Aeghur/2026_10_6/dpll_dds_fpga/mspm0/Keil_DPLL/README.md

# MSPM0G3519 DPLL控制工程

Keil入口：`Project/dpll_dds.uvprojx`。

已使用Keil µVision 5、ARM Compiler 6.24完成全量编译：0 error、0 warning。
本机生成的烧录文件位于`Output/dpll_dds_mspm0.hex`；`Output`属于构建产物，
不提交Git，可随时由工程重新生成。

功能：

- UART4以2 Mbaud连接DPLL FPGA；
- UART1以1 Mbaud连接PC；
- 将PC的0～359.99°目标相位转换为32 bit FPGA相位字；
- 查询FPGA频率、锁定、OTR和DAC削顶状态；
- 保持现有`scope.py`的设置相位、单次采集和结果帧兼容。
- 支持`dpll_control.py`实时读取频率、锁定、相位误差和DAC码。

PC UART1的时钟分频、中断方式和引脚配置与已上板验证可通信的旧工程保持一致；
FPGA UART4状态查询带有限超时，FPGA未连接时MSPM0仍会及时向PC返回错误帧。

新FPGA不再上传4096点ADC/FFT数据，因此兼容结果中仅返回一个中心采样点和
一个状态幅值点。PC界面仍可显示频率、CRC、OTR、DAC削顶和调相状态，时域及
频谱图不再代表实际采集波形。

工程复用仓库根目录`KeyBoardpro/Source`中的TI DriverLib，避免复制整套SDK。
因此不要单独移动本目录；应保持它位于当前仓库结构中。

接线：

| 方向 | MSPM0 | FPGA | 波特率 |
|---|---|---|---:|
| MSPM0→FPGA | PB10/UART4_TX | T13/uart_rx | 2 Mbaud |
| FPGA→MSPM0 | PB11/UART4_RX | R13/uart_tx | 2 Mbaud |
| PC→MSPM0 | PB5/UART1_RX | USB-TTL TX | 1 Mbaud |
| MSPM0→PC | PB4/UART1_TX | USB-TTL RX | 1 Mbaud |

所有数字设备使用3.3 V逻辑并共地。

烧录与启动：

1. 用Keil打开`Project/dpll_dds.uvprojx`，选择`DPLL_DDS_MSPM0G3519`。
2. 执行Build，确认生成`Output/dpll_dds_mspm0.hex`。
3. 用UniFlash烧录该HEX；如果已经在Keil目标选项中配置好板载调试器，也可直接Download。
4. FPGA先烧录`quartus/output_files/dpll_dds.sof`，再给MSPM0复位。
5. PC运行仓库原界面，选择MSPM0对应串口和1,000,000 baud。

推荐使用根目录的DPLL专用诊断脚本进行首次调试：

```powershell
cd E:\eishero2q\ad9226
python -m pip install -r requirements.txt
python dpll_control.py --port COM6 --phase 0
```

将`COM6`换成设备管理器中USB-TTL对应端口。按`Ctrl+C`停止；测试90°时重新运行
并改为`--phase 90`。脚本每250 ms显示频率、锁定、输入有效、环路相位误差、
当前DAC码、削顶和ADC OTR。

上电后MSPM0会自动向FPGA发送0°、幅度2143、相位校准180°、输出使能的默认配置。
180°固定校准来自40 kHz上板验证：未校准时物理输入/输出约反相，临时设置
180°命令后示波器读数变为约5.945°/354.0°。该固定项只修正板级极性，剩余
频率相关残差应通过后续扫频表补偿。
如果暂时不接MSPM0，FPGA的UART RX必须上拉到3.3 V；DPLL实时锁相本身仍在FPGA
中运行，但不能从PC设置相位或读取状态。
