Aeghur/2026_10_6/dpll_dds_fpga/mspm0/Keil_DPLL/User/ti_msp_dl_config.c

/*
 * Copyright (c) 2023, Texas Instruments Incorporated
 * All rights reserved.
 *
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
 * *  Redistributions of source code must retain the above copyright
 *    notice, this list of conditions and the following disclaimer.
 *
 * *  Redistributions in binary form must reproduce the above copyright
 *    notice, this list of conditions and the following disclaimer in the
 *    documentation and/or other materials provided with the distribution.
 *
 * *  Neither the name of Texas Instruments Incorporated nor the names of
 *    its contributors may be used to endorse or promote products derived
 *    from this software without specific prior written permission.
 *
 * THIS SOFTWARE IS PROVIDED BY THE COPYRIGHT HOLDERS AND CONTRIBUTORS "AS IS"
 * AND ANY EXPRESS OR IMPLIED WARRANTIES, INCLUDING, BUT NOT LIMITED TO,
 * THE IMPLIED WARRANTIES OF MERCHANTABILITY AND FITNESS FOR A PARTICULAR
 * PURPOSE ARE DISCLAIMED. IN NO EVENT SHALL THE COPYRIGHT OWNER OR
 * CONTRIBUTORS BE LIABLE FOR ANY DIRECT, INDIRECT, INCIDENTAL, SPECIAL,
 * EXEMPLARY, OR CONSEQUENTIAL DAMAGES (INCLUDING, BUT NOT LIMITED TO,
 * PROCUREMENT OF SUBSTITUTE GOODS OR SERVICES; LOSS OF USE, DATA, OR PROFITS;
 * OR BUSINESS INTERRUPTION) HOWEVER CAUSED AND ON ANY THEORY OF LIABILITY,
 * WHETHER IN CONTRACT, STRICT LIABILITY, OR TORT (INCLUDING NEGLIGENCE OR
 * OTHERWISE) ARISING IN ANY WAY OUT OF THE USE OF THIS SOFTWARE,
 * EVEN IF ADVISED OF THE POSSIBILITY OF SUCH DAMAGE.
 */

/*
 *  ============ ti_msp_dl_config.c =============
 *  Configured MSPM0 DriverLib module definitions
 *
 *  DO NOT EDIT - This file is generated for the MSPM0G351X
 *  by the SysConfig tool.
 */

#include "ti_msp_dl_config.h"

DL_TimerA_backupConfig gTIMER_A1Backup;
DL_SPI_backupConfig gSPI_0Backup;
DL_TRNG_backupConfig gTRNGBackup;

/*
 *  ======== SYSCFG_DL_init ========
 *  Perform any initialization needed before using any board APIs
 */
SYSCONFIG_WEAK void SYSCFG_DL_init(void)
{
    SYSCFG_DL_initPower();
    SYSCFG_DL_GPIO_init();
    /* Module-Specific Initializations*/
    SYSCFG_DL_SYSCTL_init();
    SYSCFG_DL_TIMER_A1_init();
    SYSCFG_DL_SPI_0_init();
    SYSCFG_DL_TRNG_init();
    /* Ensure backup structures have no valid state */
	gTIMER_A1Backup.backupRdy 	= false;
	gSPI_0Backup.backupRdy 	= false;
	gTRNGBackup.backupRdy 	= false;

}
/*
 * User should take care to save and restore register configuration in application.
 * See Retention Configuration section for more details.
 */
SYSCONFIG_WEAK bool SYSCFG_DL_saveConfiguration(void)
{
    bool retStatus = true;

	retStatus &= DL_TimerA_saveConfiguration(TIMER_A1_INST, &gTIMER_A1Backup);
	retStatus &= DL_SPI_saveConfiguration(SPI_0_INST, &gSPI_0Backup);
	retStatus &= DL_TRNG_saveConfiguration(TRNG, &gTRNGBackup);

    return retStatus;
}


SYSCONFIG_WEAK bool SYSCFG_DL_restoreConfiguration(void)
{
    bool retStatus = true;

	retStatus &= DL_TimerA_restoreConfiguration(TIMER_A1_INST, &gTIMER_A1Backup, false);
	retStatus &= DL_SPI_restoreConfiguration(SPI_0_INST, &gSPI_0Backup);
	retStatus &= DL_TRNG_restoreConfiguration(TRNG, &gTRNGBackup);

    return retStatus;
}

SYSCONFIG_WEAK void SYSCFG_DL_initPower(void)
{
    DL_GPIO_reset(GPIOA);
    DL_GPIO_reset(GPIOB);
    DL_GPIO_reset(GPIOC);
    DL_TimerA_reset(TIMER_A1_INST);
    DL_SPI_reset(SPI_0_INST);
    DL_TRNG_reset(TRNG);

    DL_GPIO_enablePower(GPIOA);
    DL_GPIO_enablePower(GPIOB);
    DL_GPIO_enablePower(GPIOC);
    DL_TimerA_enablePower(TIMER_A1_INST);
    DL_SPI_enablePower(SPI_0_INST);
    DL_TRNG_enablePower(TRNG);
    delay_cycles(POWER_STARTUP_DELAY);
}

SYSCONFIG_WEAK void SYSCFG_DL_GPIO_init(void)
{

    DL_GPIO_initPeripheralAnalogFunction(GPIO_HFXIN_IOMUX);
    DL_GPIO_initPeripheralAnalogFunction(GPIO_HFXOUT_IOMUX);

    DL_GPIO_initPeripheralOutputFunction(
        GPIO_SPI_0_IOMUX_SCLK, GPIO_SPI_0_IOMUX_SCLK_FUNC);
    DL_GPIO_initPeripheralOutputFunction(
        GPIO_SPI_0_IOMUX_PICO, GPIO_SPI_0_IOMUX_PICO_FUNC);

    DL_GPIO_initDigitalOutputFeatures(LED_L1_IOMUX,
		 DL_GPIO_INVERSION_DISABLE, DL_GPIO_RESISTOR_PULL_UP,
		 DL_GPIO_DRIVE_STRENGTH_LOW, DL_GPIO_HIZ_DISABLE);

    DL_GPIO_initDigitalOutput(OLED_RES_IOMUX);

    DL_GPIO_initDigitalOutput(OLED_DC_IOMUX);

    DL_GPIO_initDigitalOutput(OLED_CS_IOMUX);

    DL_GPIO_initDigitalOutput(KeyBoard_H1_IOMUX);

    DL_GPIO_initDigitalOutput(KeyBoard_H2_IOMUX);

    DL_GPIO_initDigitalOutput(KeyBoard_H3_IOMUX);

    DL_GPIO_initDigitalOutput(KeyBoard_H4_IOMUX);

    DL_GPIO_initDigitalInputFeatures(KeyBoard_V1_IOMUX,
		 DL_GPIO_INVERSION_DISABLE, DL_GPIO_RESISTOR_PULL_UP,
		 DL_GPIO_HYSTERESIS_DISABLE, DL_GPIO_WAKEUP_DISABLE);

    DL_GPIO_initDigitalInputFeatures(KeyBoard_V2_IOMUX,
		 DL_GPIO_INVERSION_DISABLE, DL_GPIO_RESISTOR_PULL_UP,
		 DL_GPIO_HYSTERESIS_DISABLE, DL_GPIO_WAKEUP_DISABLE);

    DL_GPIO_initDigitalInputFeatures(KeyBoard_V3_IOMUX,
		 DL_GPIO_INVERSION_DISABLE, DL_GPIO_RESISTOR_PULL_UP,
		 DL_GPIO_HYSTERESIS_DISABLE, DL_GPIO_WAKEUP_DISABLE);

    DL_GPIO_initDigitalInputFeatures(KeyBoard_V4_IOMUX,
		 DL_GPIO_INVERSION_DISABLE, DL_GPIO_RESISTOR_PULL_UP,
		 DL_GPIO_HYSTERESIS_DISABLE, DL_GPIO_WAKEUP_DISABLE);

    DL_GPIO_initDigitalOutput(AD9833_DDS_FSYNC_IOMUX);

    DL_GPIO_initDigitalOutput(AD9833_DDS_SCLK_IOMUX);

    DL_GPIO_initDigitalOutput(AD9833_DDS_SDATA_IOMUX);

    DL_GPIO_clearPins(GPIOA, LED_L1_PIN |
		AD9833_DDS_FSYNC_PIN |
		AD9833_DDS_SCLK_PIN |
		AD9833_DDS_SDATA_PIN);
    DL_GPIO_enableOutput(GPIOA, LED_L1_PIN |
		AD9833_DDS_FSYNC_PIN |
		AD9833_DDS_SCLK_PIN |
		AD9833_DDS_SDATA_PIN);
    DL_GPIO_clearPins(GPIOB, OLED_RES_PIN |
		KeyBoard_H1_PIN |
		KeyBoard_H2_PIN |
		KeyBoard_H3_PIN |
		KeyBoard_H4_PIN);
    DL_GPIO_enableOutput(GPIOB, OLED_RES_PIN |
		KeyBoard_H1_PIN |
		KeyBoard_H2_PIN |
		KeyBoard_H3_PIN |
		KeyBoard_H4_PIN);
    DL_GPIO_clearPins(GPIOC, OLED_DC_PIN |
		OLED_CS_PIN);
    DL_GPIO_enableOutput(GPIOC, OLED_DC_PIN |
		OLED_CS_PIN);

}


static const DL_SYSCTL_SYSPLLConfig gSYSPLLConfig = {
    .inputFreq              = DL_SYSCTL_SYSPLL_INPUT_FREQ_32_48_MHZ,
	.rDivClk2x              = 1,
	.rDivClk1               = 0,
	.rDivClk0               = 0,
	.enableCLK2x            = DL_SYSCTL_SYSPLL_CLK2X_DISABLE,
	.enableCLK1             = DL_SYSCTL_SYSPLL_CLK1_DISABLE,
	.enableCLK0             = DL_SYSCTL_SYSPLL_CLK0_ENABLE,
	.sysPLLMCLK             = DL_SYSCTL_SYSPLL_MCLK_CLK0,
	.sysPLLRef              = DL_SYSCTL_SYSPLL_REF_HFCLK,
	.qDiv                   = 3,
	.pDiv                   = DL_SYSCTL_SYSPLL_PDIV_1
};
SYSCONFIG_WEAK void SYSCFG_DL_SYSCTL_init(void)
{

	//Low Power Mode is configured to be SLEEP0
    DL_SYSCTL_setBORThreshold(DL_SYSCTL_BOR_THRESHOLD_LEVEL_0);
    DL_SYSCTL_setFlashWaitState(DL_SYSCTL_FLASH_WAIT_STATE_2);

    
	DL_SYSCTL_setSYSOSCFreq(DL_SYSCTL_SYSOSC_FREQ_BASE);
	/* Set default configuration */
	DL_SYSCTL_disableHFXT();
	DL_SYSCTL_disableSYSPLL();
    DL_SYSCTL_setHFCLKSourceHFXTParams(DL_SYSCTL_HFXT_RANGE_32_48_MHZ,10, false);
    DL_SYSCTL_configSYSPLL((DL_SYSCTL_SYSPLLConfig *) &gSYSPLLConfig);
    DL_SYSCTL_setULPCLKDivider(DL_SYSCTL_ULPCLK_DIV_2);
    DL_SYSCTL_setHFCLKDividerForMFPCLK(DL_SYSCTL_HFCLK_MFPCLK_DIVIDER_10);
    DL_SYSCTL_enableMFCLK();
    DL_SYSCTL_enableMFPCLK();
	DL_SYSCTL_setMFPCLKSource(DL_SYSCTL_MFPCLK_SOURCE_HFCLK);
    DL_SYSCTL_setMCLKSource(SYSOSC, HSCLK, DL_SYSCTL_HSCLK_SOURCE_SYSPLL);

}



/*
 * Timer clock configuration to be sourced by MFCLK /  (4000000 Hz)
 * timerClkFreq = (timerClkSrc / (timerClkDivRatio * (timerClkPrescale + 1)))
 *   4000000 Hz = 4000000 Hz / (1 * (0 + 1))
 */
static const DL_TimerA_ClockConfig gTIMER_A1ClockConfig = {
    .clockSel    = DL_TIMER_CLOCK_MFCLK,
    .divideRatio = DL_TIMER_CLOCK_DIVIDE_1,
    .prescale    = 0U,
};

/*
 * Timer load value (where the counter starts from) is calculated as (timerPeriod * timerClockFreq) - 1
 * TIMER_A1_INST_LOAD_VALUE = (10us * 4000000 Hz) - 1
 */
static const DL_TimerA_TimerConfig gTIMER_A1TimerConfig = {
    .period     = TIMER_A1_INST_LOAD_VALUE,
    .timerMode  = DL_TIMER_TIMER_MODE_PERIODIC,
    .startTimer = DL_TIMER_STOP,
};

SYSCONFIG_WEAK void SYSCFG_DL_TIMER_A1_init(void) {

    DL_TimerA_setClockConfig(TIMER_A1_INST,
        (DL_TimerA_ClockConfig *) &gTIMER_A1ClockConfig);

    DL_TimerA_initTimerMode(TIMER_A1_INST,
        (DL_TimerA_TimerConfig *) &gTIMER_A1TimerConfig);
    DL_TimerA_enableClock(TIMER_A1_INST);





}


static const DL_SPI_Config gSPI_0_config = {
    .mode        = DL_SPI_MODE_CONTROLLER,
    .frameFormat = DL_SPI_FRAME_FORMAT_MOTO3_POL1_PHA0,
    .parity      = DL_SPI_PARITY_NONE,
    .dataSize    = DL_SPI_DATA_SIZE_8,
    .bitOrder    = DL_SPI_BIT_ORDER_MSB_FIRST,
};

static const DL_SPI_ClockConfig gSPI_0_clockConfig = {
    .clockSel    = DL_SPI_CLOCK_BUSCLK,
    .divideRatio = DL_SPI_CLOCK_DIVIDE_RATIO_1
};

SYSCONFIG_WEAK void SYSCFG_DL_SPI_0_init(void) {
    DL_SPI_setClockConfig(SPI_0_INST, (DL_SPI_ClockConfig *) &gSPI_0_clockConfig);

    DL_SPI_init(SPI_0_INST, (DL_SPI_Config *) &gSPI_0_config);

    /* Configure Controller mode */
    /*
     * Set the bit rate clock divider to generate the serial output clock
     *     outputBitRate = (spiInputClock) / ((1 + SCR) * 2)
     *     20000000 = (80000000)/((1 + 1) * 2)
     */
    DL_SPI_setBitRateSerialClockDivider(SPI_0_INST, 1);
    /* Set RX and TX FIFO threshold levels */
    DL_SPI_setFIFOThreshold(SPI_0_INST, DL_SPI_RX_FIFO_LEVEL_1_2_FULL, DL_SPI_TX_FIFO_LEVEL_1_2_EMPTY);

    /* Enable module */
    DL_SPI_enable(SPI_0_INST);
}

SYSCONFIG_WEAK void SYSCFG_DL_TRNG_init(void)
{
    DL_TRNG_setClockDivider(TRNG, DL_TRNG_CLOCK_DIVIDE_8);

    DL_TRNG_sendCommand(TRNG, DL_TRNG_CMD_NORM_FUNC);
    while (!DL_TRNG_isCommandDone(TRNG))
        ;
    DL_TRNG_clearInterruptStatus(TRNG, DL_TRNG_INTERRUPT_CMD_DONE_EVENT);

    DL_TRNG_setDecimationRate(TRNG, DL_TRNG_DECIMATION_RATE_4);
}
