Aeghur/2026_10_6/tb_zero_crossing_dds.v

`timescale 1ns/1ps
module tb_zero_crossing_dds #(
    parameter integer SAMPLE_HZ = 1_000_000,
    parameter integer TONE_HZ = 10_000,
    parameter integer STEP_ERROR_PPM = 0
);
    localparam integer TEST_SAMPLES = 5 * SAMPLE_HZ / TONE_HZ;
    localparam [63:0] EXACT_PHASE_STEP =
        (64'd4294967296 * TONE_HZ) / SAMPLE_HZ;
    localparam [31:0] PHASE_STEP =
        (EXACT_PHASE_STEP * (1_000_000 + STEP_ERROR_PPM)) / 1_000_000;
    reg clk = 0;
    reg rst = 1;
    reg enable = 1;
    reg config_valid = 0;
    reg [31:0] config_phase_step = PHASE_STEP;
    reg [31:0] config_phase_lag = 0;
    reg sample_valid = 0;
    reg [11:0] sample_data = 12'd2104;
    wire output_valid;
    wire [11:0] output_sample;
    wire locked;
    wire signal_present;
    wire output_valid_180;
    wire [11:0] output_sample_180;
    wire locked_180;
    wire signal_present_180;
    integer sample_index = 0;
    integer valid_count = 0;
    integer minimum_output = 4095;
    integer maximum_output = 0;
    integer inversion_errors = 0;
    integer previous_output = 2104;
    integer maximum_step = 0;
    integer output_step = 0;
    integer arm_samples = 0;
    integer crossing_samples = 0;
    real angle;
    real sample_real;

    always #10 clk = ~clk;

    zero_crossing_dds #(
        .ADC_ZERO_CODE(2104),
        .SAMPLE_HZ(SAMPLE_HZ),
        .PIPELINE_ADVANCE_SAMPLES(10)
    ) dut (
        .clk(clk), .rst(rst), .enable(enable),
        .config_valid(config_valid),
        .config_phase_step(config_phase_step),
        .config_phase_lag(config_phase_lag),
        .sample_valid(sample_valid), .sample_data(sample_data),
        .output_valid(output_valid), .output_sample(output_sample),
        .locked(locked), .signal_present(signal_present)
    );

    zero_crossing_dds #(
        .ADC_ZERO_CODE(2104),
        .SAMPLE_HZ(SAMPLE_HZ),
        .PIPELINE_ADVANCE_SAMPLES(10)
    ) dut_180 (
        .clk(clk), .rst(rst), .enable(enable),
        .config_valid(config_valid),
        .config_phase_step(config_phase_step),
        .config_phase_lag(32'h80000000),
        .sample_valid(sample_valid), .sample_data(sample_data),
        .output_valid(output_valid_180),
        .output_sample(output_sample_180),
        .locked(locked_180), .signal_present(signal_present_180)
    );

    always @(posedge clk) begin
        sample_valid <= ~sample_valid;
        if (!sample_valid) begin
            angle = 6.283185307179586 * TONE_HZ * sample_index / SAMPLE_HZ;
            sample_real = 2104.0 + 500.0 * $sin(angle);
            sample_data <= $rtoi(sample_real);
            sample_index <= sample_index + 1;
        end
        if (output_valid) begin
            valid_count <= valid_count + 1;
            output_step = (output_sample >= previous_output) ?
                          output_sample - previous_output :
                          previous_output - output_sample;
            if (dut.amplitude_ramp >= 400 && output_step > maximum_step)
                maximum_step <= output_step;
            previous_output <= output_sample;
            if (output_sample < minimum_output)
                minimum_output <= output_sample;
            if (output_sample > maximum_output)
                maximum_output <= output_sample;
            if (output_valid_180 && valid_count > 20 &&
                (output_sample + output_sample_180 < 4206 ||
                 output_sample + output_sample_180 > 4210))
                inversion_errors <= inversion_errors + 1;
        end
        if (sample_valid && sample_data <= 2096)
            arm_samples <= arm_samples + 1;
        if (sample_valid && dut.crossing_armed && sample_data >= 2104)
            crossing_samples <= crossing_samples + 1;
    end

    initial begin
        #200;
        rst = 0;
        @(posedge clk);
        config_valid = 1;
        @(posedge clk);
        config_valid = 0;
        repeat (TEST_SAMPLES * 2) @(posedge clk);
        if (!signal_present || !locked || !signal_present_180 ||
            !locked_180) begin
            $display("FAIL: DDS acquire signal=%0d lock=%0d envelope=%0d armed=%0d age=%0d samples=%0d step=%0d arm=%0d cross=%0d",
                     signal_present, locked, dut.envelope,
                     dut.crossing_armed, dut.samples_since_crossing,
                     sample_index, dut.phase_step, arm_samples,
                     crossing_samples);
            $finish;
        end
        if (valid_count < TEST_SAMPLES / 2 || minimum_output > 1700 ||
            maximum_output < 2500 || inversion_errors != 0 ||
            maximum_step > 64 ||
            (STEP_ERROR_PPM != 0 && dut.frequency_trim == 0)) begin
            $display("FAIL: invalid DDS output count/range/step %0d %0d %0d %0d",
                     valid_count, minimum_output, maximum_output, maximum_step);
            $finish;
        end
        $display("PASS: continuous-phase DDS lock, max code step=%0d",
                 maximum_step);
        $finish;
    end

endmodule
