Aeghur/2026_10_6/KeyBoardpro/User/fpga_capture.h

#ifndef FPGA_CAPTURE_H
#define FPGA_CAPTURE_H

#include <stdint.h>

typedef enum {
    FPGA_CAPTURE_OK = 0,
    FPGA_CAPTURE_TIMEOUT = 1,
    FPGA_CAPTURE_FORMAT_ERROR = 2,
    FPGA_CAPTURE_CRC_ERROR = 3
} FPGA_CaptureStatus;

FPGA_CaptureStatus FPGA_Capture_Run(
    uint8_t sequence, uint16_t *samples, uint16_t *flags);
void FPGA_Capture_SetDelay(uint8_t sequence, uint16_t delaySamples);
void FPGA_Capture_SetOutput(
    uint8_t sequence, uint8_t mode, uint32_t phaseStep,
    uint32_t phaseLag);

#endif
