Aeghur/2026_10_6/uart_rx.v

module uart_rx #(
    parameter integer CLK_HZ = 50_000_000,
    parameter integer BAUD   = 2_000_000
) (
    input  wire       clk,
    input  wire       rst,
    input  wire       rx,
    output reg  [7:0] data = 8'd0,
    output reg        valid = 1'b0,
    output reg        framing_error = 1'b0
);
    // Round to the nearest whole system-clock count.  At 50 MHz and
    // The rounded divider supports both the 2 Mbaud production link and
    // slower parameterized simulation/debug configurations.
    localparam integer CLKS_PER_BIT = (CLK_HZ + BAUD / 2) / BAUD;
    localparam integer HALF_BIT = CLKS_PER_BIT / 2;
    localparam [15:0] START_COUNT = HALF_BIT - 1;
    localparam [15:0] DATA_COUNT  = CLKS_PER_BIT - 1;

    reg rx_meta = 1'b1;
    reg rx_sync = 1'b1;
    reg rx_prev = 1'b1;
    reg busy = 1'b0;
    reg [15:0] clock_count = 16'd0;
    reg [3:0] bit_index = 4'd0;
    reg [7:0] shift = 8'd0;

    always @(posedge clk) begin
        rx_meta <= rx;
        rx_sync <= rx_meta;
        rx_prev <= rx_sync;
        valid <= 1'b0;
        framing_error <= 1'b0;

        if (rst) begin
            busy        <= 1'b0;
            clock_count <= 16'd0;
            bit_index   <= 4'd0;
            rx_meta     <= 1'b1;
            rx_sync     <= 1'b1;
            rx_prev     <= 1'b1;
        end else if (!busy) begin
            if (rx_prev && !rx_sync) begin
                busy        <= 1'b1;
                clock_count <= START_COUNT;
                bit_index   <= 4'd0;
            end
        end else if (clock_count != 0) begin
            clock_count <= clock_count - 1'b1;
        end else if (bit_index == 0) begin
            if (rx_sync) begin
                busy <= 1'b0; // false start
            end else begin
                bit_index   <= 4'd1;
                clock_count <= DATA_COUNT;
            end
        end else if (bit_index <= 8) begin
            shift[bit_index - 1'b1] <= rx_sync;
            bit_index   <= bit_index + 1'b1;
            clock_count <= DATA_COUNT;
        end else begin
            busy <= 1'b0;
            if (rx_sync) begin
                data  <= shift;
                valid <= 1'b1;
            end else begin
                framing_error <= 1'b1;
            end
        end
    end

    initial begin
        if (CLKS_PER_BIT < 8)
            $display("ERROR: uart_rx requires at least 8 clocks per bit");
        if (CLK_HZ != CLKS_PER_BIT * BAUD)
            $display("INFO: UART RX uses rounded clocks-per-bit");
    end
endmodule
