Aeghur/2026_10_6/(commit log)

2026-10-02 fix: poll MSPM0 PC UART commands
    [dpll_control.py, dpll_fpga_link.c, main.c, msp_uart_link.c, pc_dpll_link.c, pc_dpll_link.h]
2026-10-04 fix: restore proven MSPM0 UART link settings
    [main.c, msp_uart_link.c, pc_dpll_link.c]
2026-10-04 fix: compensate board output polarity
    [main.c]
2026-10-06 fix: extend tracked frequency range to 110 kHz
    [main.c, measurement_config.h, scope.py]
2026-11-07 feat: add standalone camera-based Lissajous phase controller
